wdathing/copico-centipede/README.md

# copico-centipede
A Radio Shack / Tandy Color Computer ("Coco") wildcard peripheral cartridge, with an RP2350 processor and 46 usable GPIO lines, covering most of the Coco's expansion port bus.
