wdathing/copico-centipede/centipede-32d/pcb-all.png

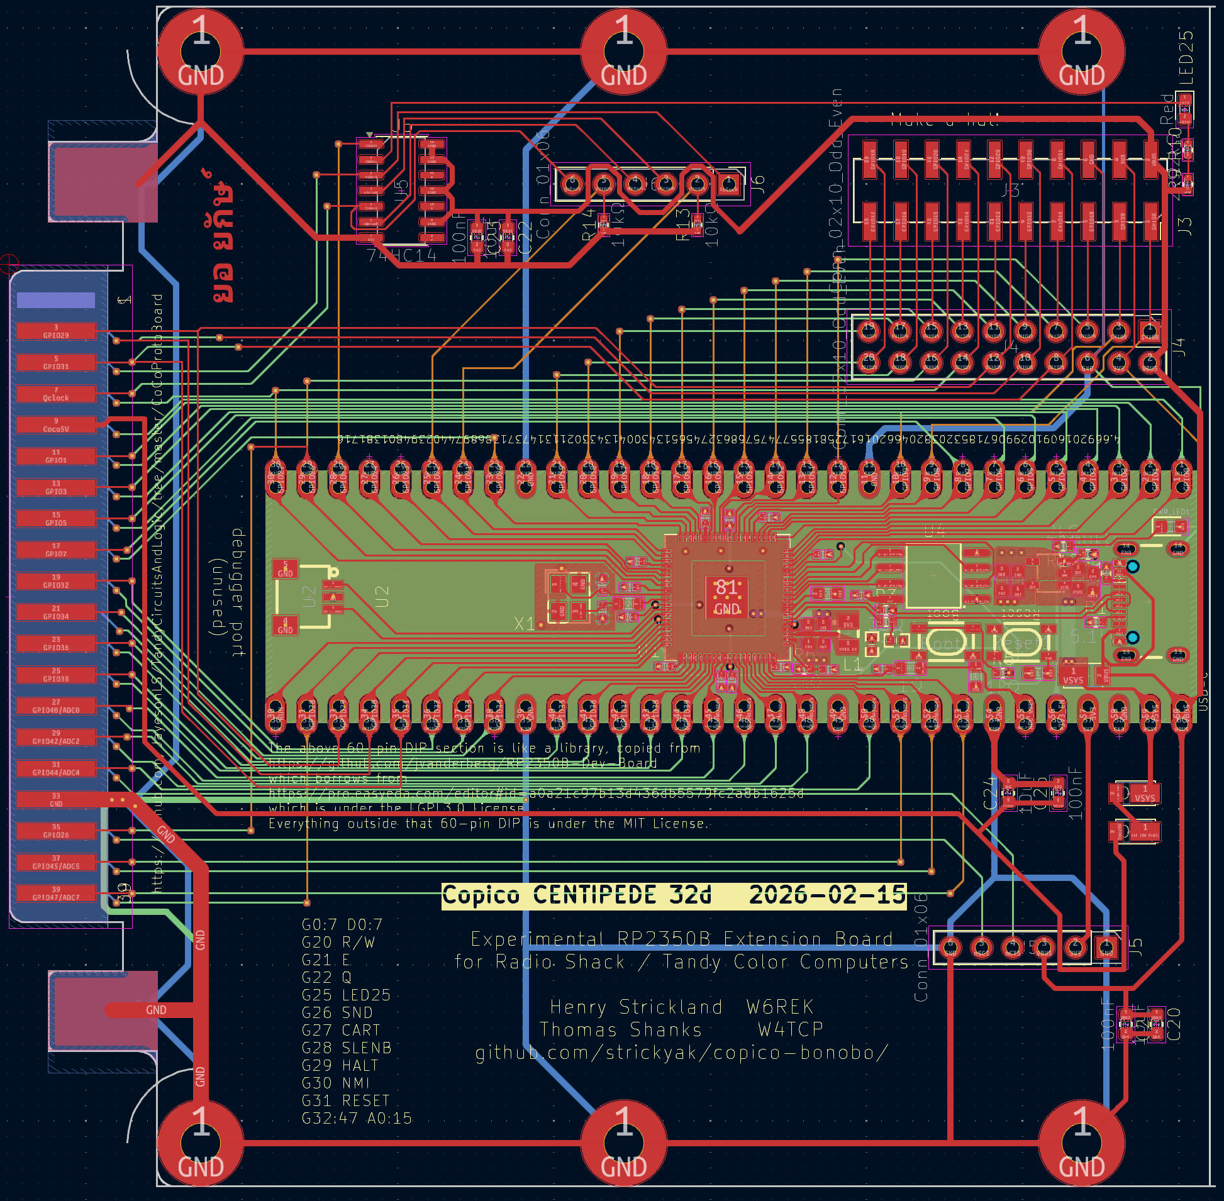
centipede-32d/pcb-all.png
