wdathing/copico-centipede/centipede-32d/pcb-j3-j4.png

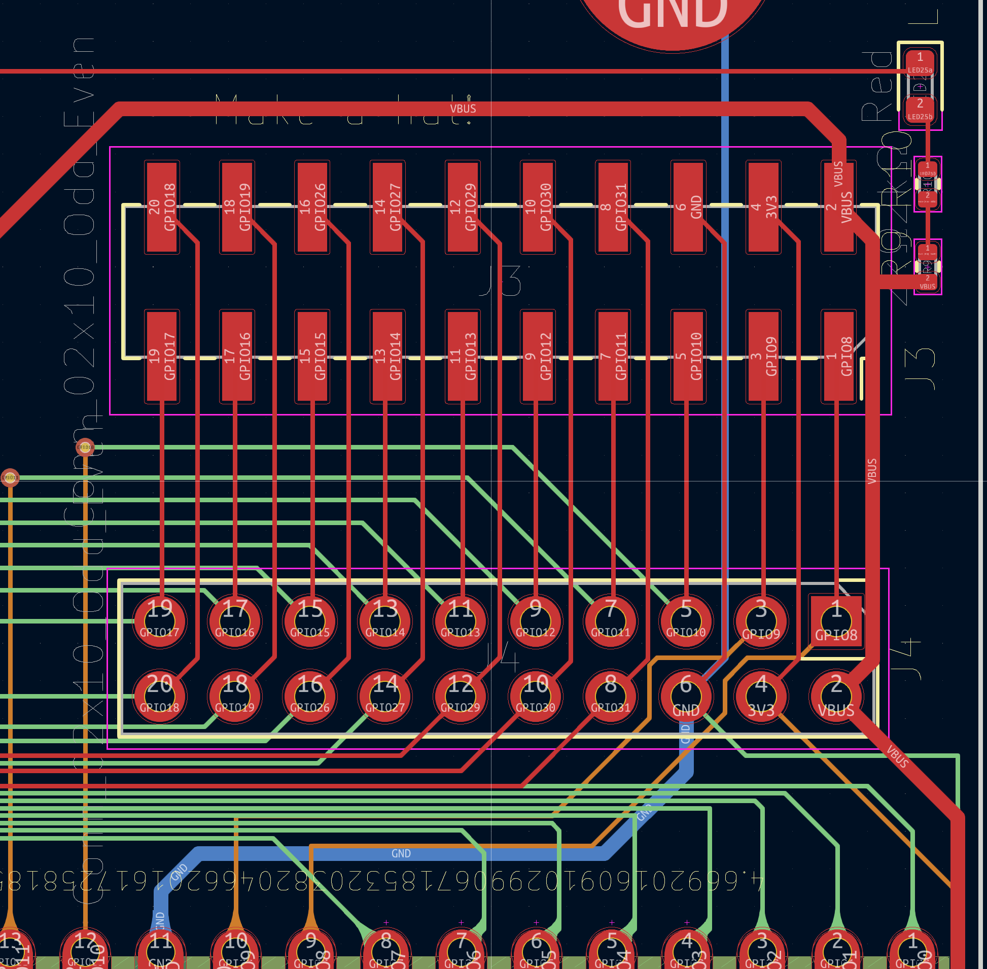
centipede-32d/pcb-j3-j4.png
