wdathing/copico-centipede/centipede-32d/pcb-j5.png

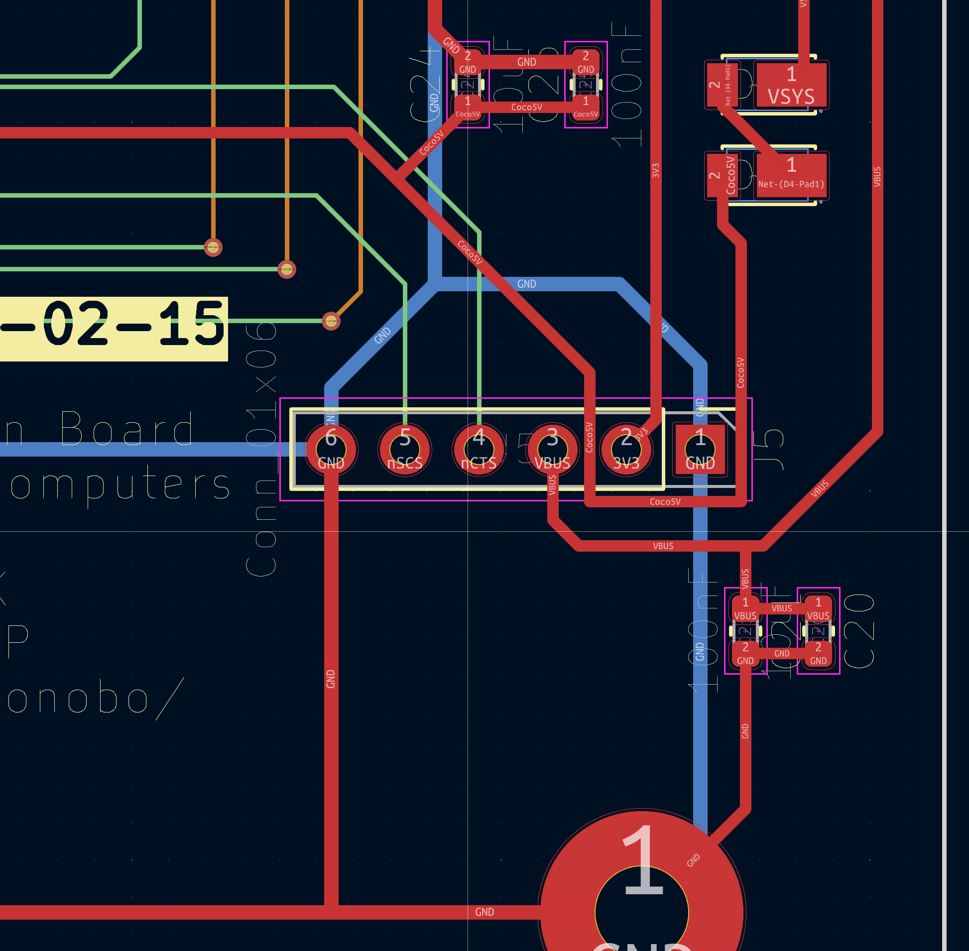
centipede-32d/pcb-j5.png
