wdathing/copico-centipede/centipede-32d/pcb-j6.png

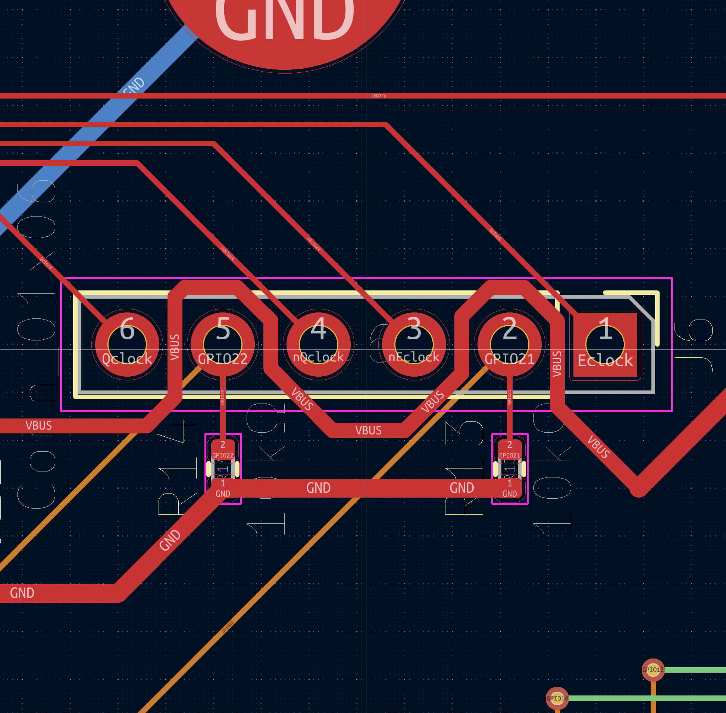
centipede-32d/pcb-j6.png
