wdathing/copico-centipede/centipede-32d/pcb-rp2350b.png

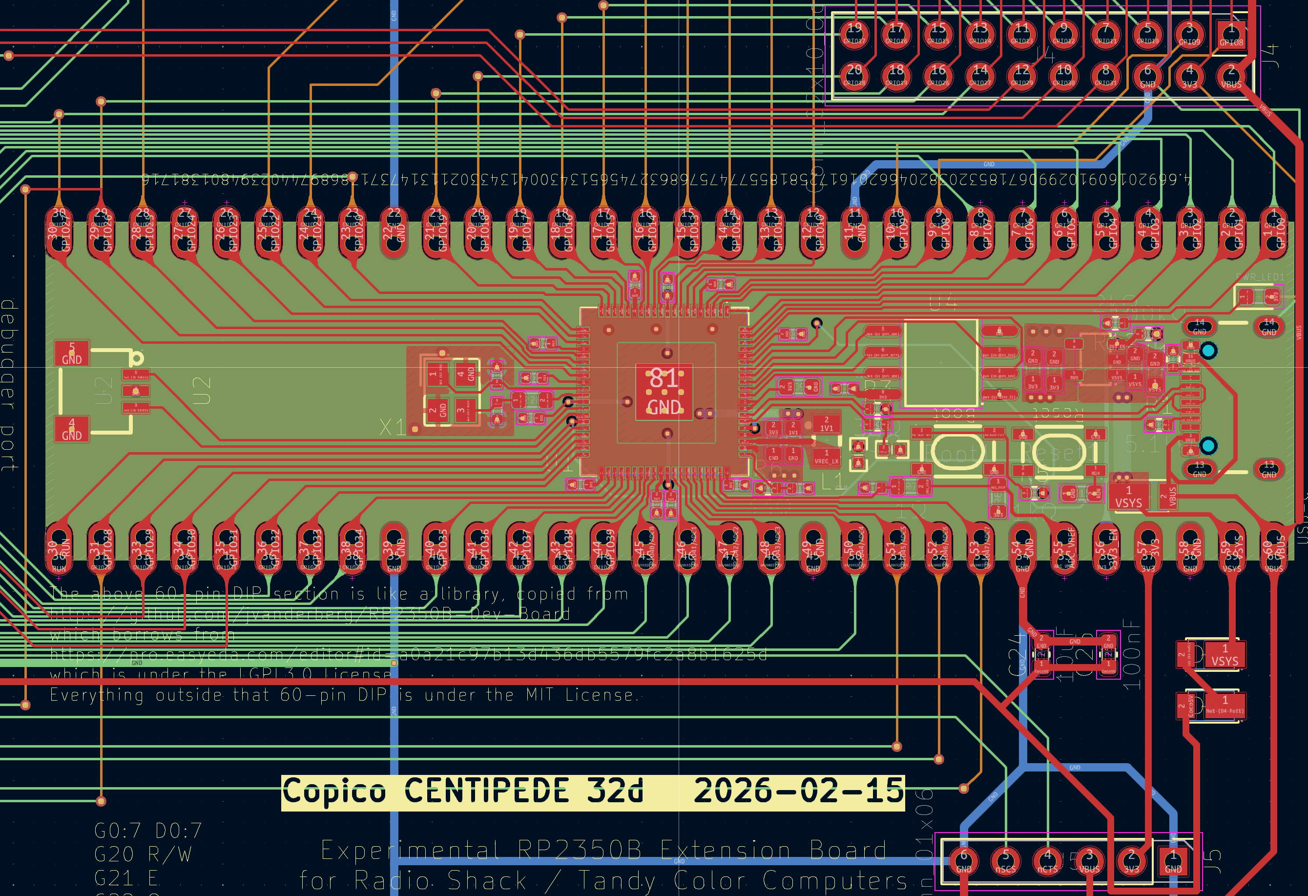
centipede-32d/pcb-rp2350b.png
