wdathing/copico-centipede/centipede-32d/schematic-additions.png

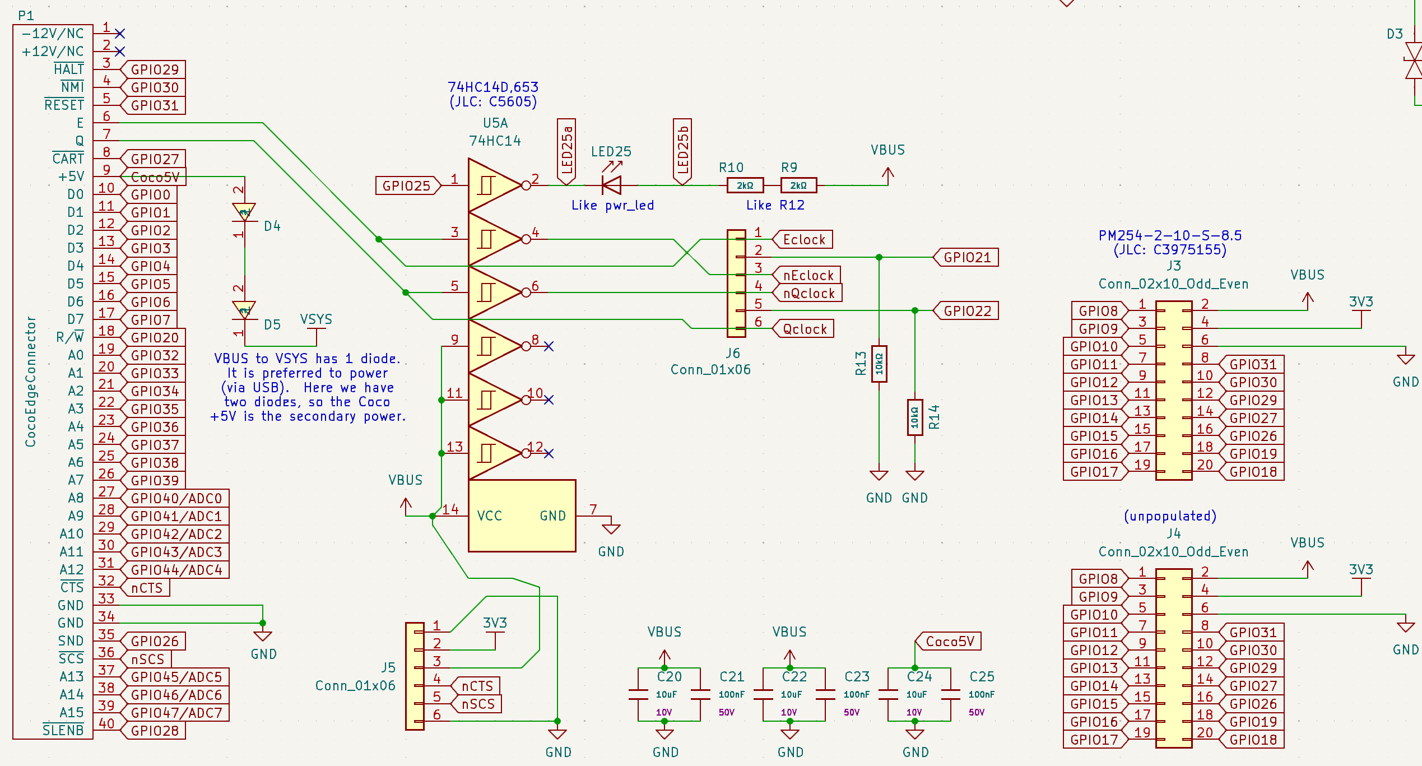
centipede-32d/schematic-additions.png
