wdathing/copico-centipede/centipede-32d/schematic.png

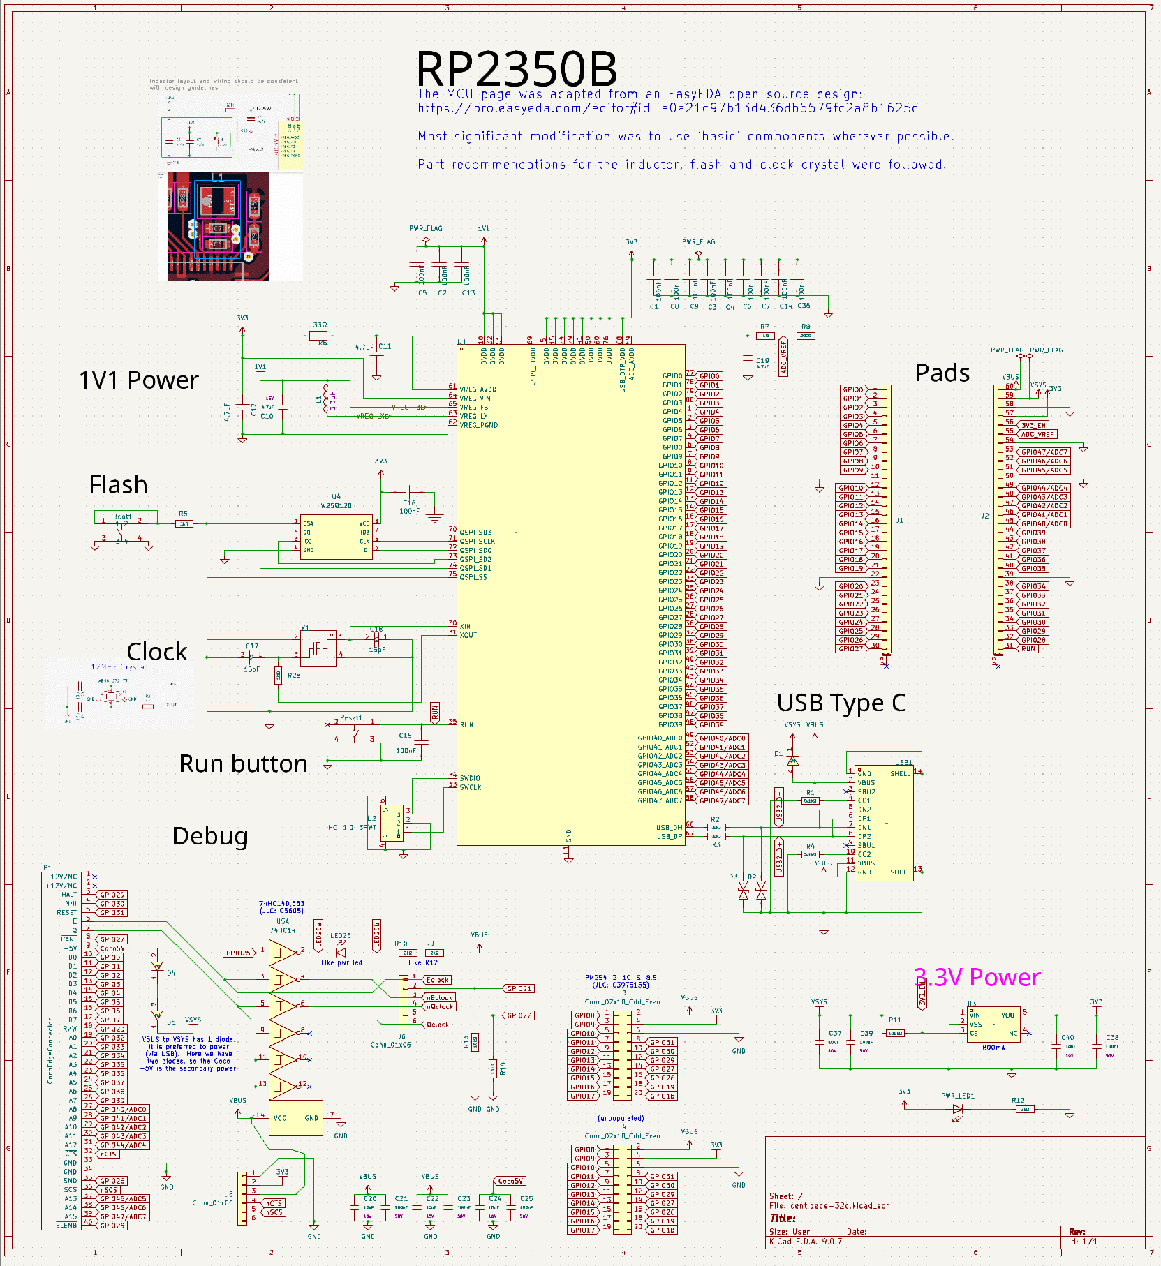
centipede-32d/schematic.png
