wdathing/copico-centipede/centipede-32e/centipede-32e.3d.png

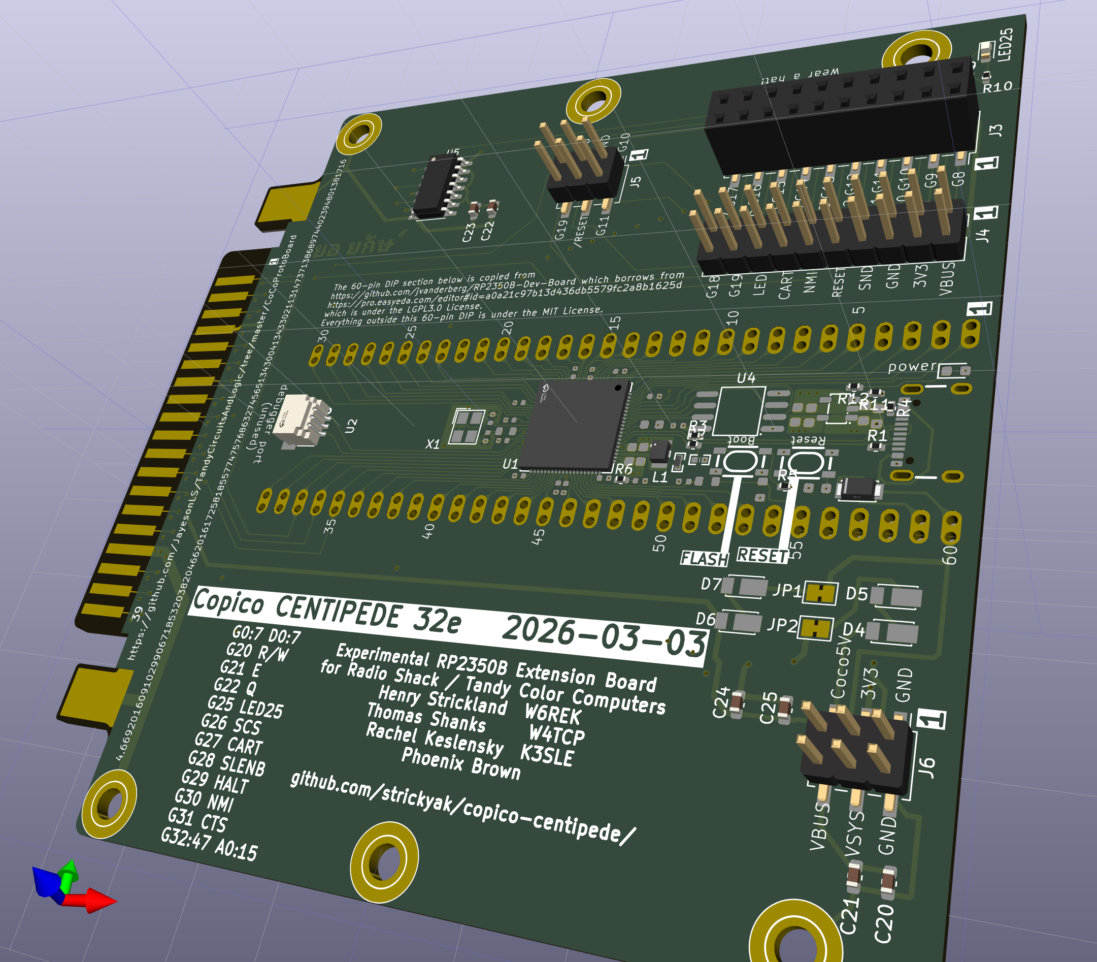
centipede-32e/centipede-32e.3d.png
