wdathing/copico-centipede/centipede-32e/centipede-32e.pcb.png

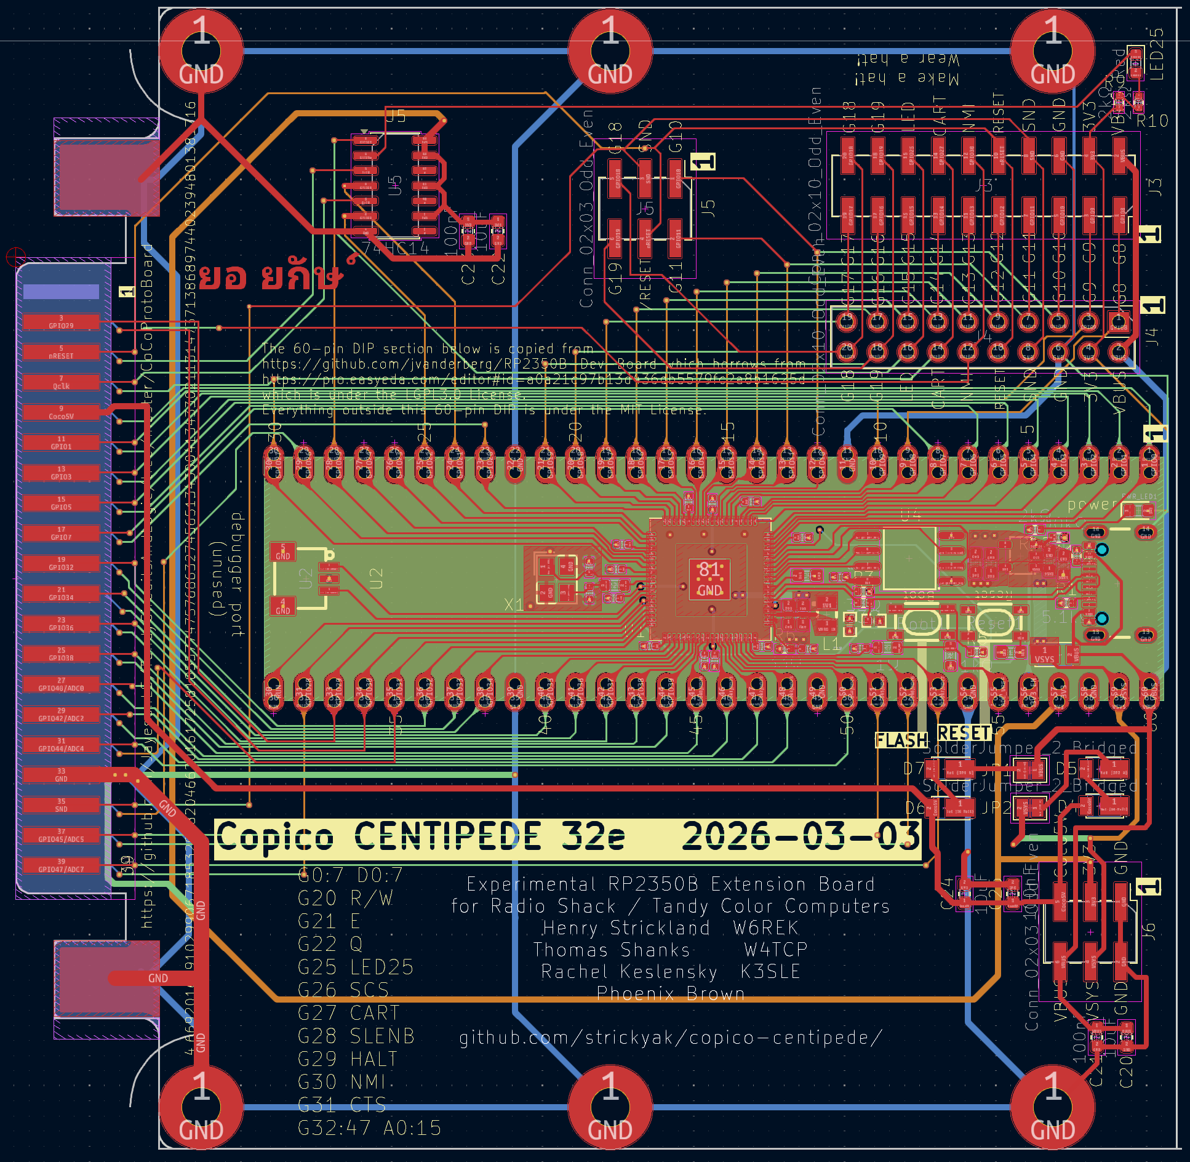
centipede-32e/centipede-32e.pcb.png
