wdathing/copico-centipede/centipede-32e/centipede-32e.sch-zoom.png

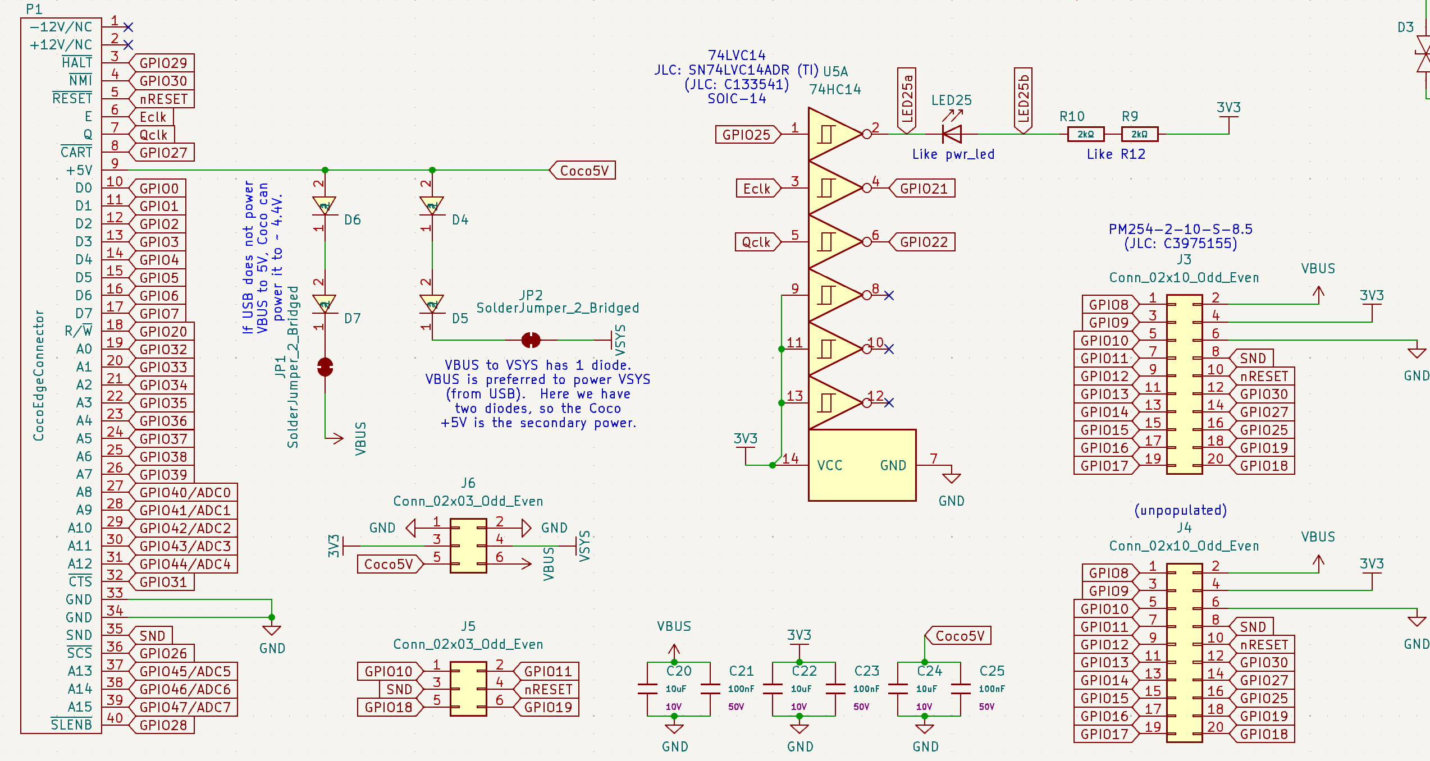
centipede-32e/centipede-32e.sch-zoom.png
