wdathing/copico-centipede/doc/talk-cocofest-2026/images/PXL_20260423_184612096.jpg

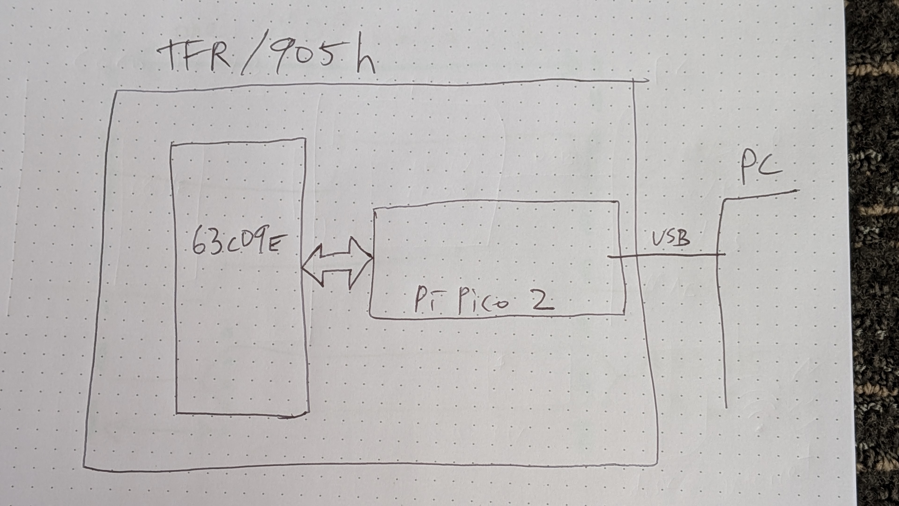
doc/talk-cocofest-2026/images/PXL_20260423_184612096.jpg
