wdathing/copico-centipede/doc/talk-cocofest-2026/images/PXL_20260423_184625592.jpg

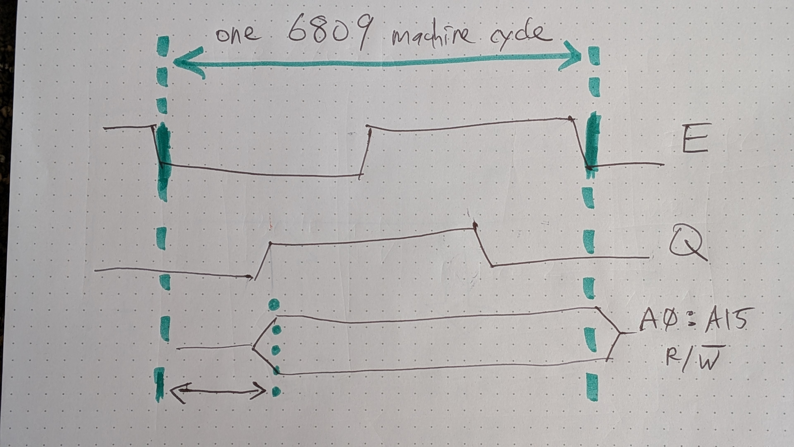
doc/talk-cocofest-2026/images/PXL_20260423_184625592.jpg
