wdathing/copico-centipede/(notices)

Notices in the files:
centipede-32z/centipede-32z.kicad_pcb:
which is under the LGPL3.0 License.
Everything outside that 60-pin DIP is under the MIT License.
centipede-32e/centipede-32e.kicad_pcb:
Everything outside this 60-pin DIP is under the MIT License.
